OpenMusicKontrollers/chimaera_sensor_unit/(commit log)

2013-07-18 new revisions for the Chimaera and Sycamore boards, directory tree rewamp ongoing
    [Chimaera_SU-16_Unit.kicad_pcb, Chimaera_SU-16_Unit.sch]
2013-08-14 DSP-F3 rev3 (+1 analog input) and SU-16 rev7 (reverse current diode), Hershey fonts for case side
    [Chimaera_SU-16_Unit.kicad_pcb, Chimaera_SU-16_Unit.sch]
2013-08-16 last changes for Alpha Batch PCBs
    [Chimaera_SU-16_Unit.kicad_pcb, Chimaera_SU-16_Unit.sch]
2013-08-27 added README.md
    [Chimaera_SU-16_Unit.kicad_pcb]
2013-08-28 outsourced common parts to library
    [Chimaera_SU-16_Unit.kicad_pcb]
2013-10-24 0.9mm (elliptical) pad holes, 0.8x0.2mm text size
    [Chimaera_SU-16_Unit.kicad_pcb, Chimaera_SU-16_Unit.sch]
2014-01-02 EDA: add missing Digi-Key part numbers
    [Chimaera_SU-16_Unit.sch]
2014-03-02 solder paste clearence for 125um mylar stencils
    [Chimaera_SU-16_Unit.kicad_pcb]
2014-03-02 path fixes after repo split
    [chimaera_sensor_unit.kicad_pcb, chimaera_sensor_unit.sch]
2014-05-13 3v3 version of Rev7
    [chimaera_sensor_unit.kicad_pcb, chimaera_sensor_unit.sch]
2014-05-20 Revision 8 with single OpAmp, one trimpot less and a cap more for 3v3
    [chimaera_sensor_unit.kicad_pcb, chimaera_sensor_unit.sch]
2014-06-12 add missing Digi-Key part numbers
    [chimaera_sensor_unit.sch]
2014-11-16 update Digi-Key part number for A1304
    [chimaera_sensor_unit.sch]
2015-04-28 update from KiCAD oldstable to rolling-release.
    [chimaera_sensor_unit.kicad_pcb, chimaera_sensor_unit.sch]
