OpenMusicKontrollers/chimaera_sensor_unit/(notices)

Notices in the files:
chimaera_sensor_unit.kicad_pcb:
Copyright (c) 2015 Hanspeter Portner (dev@open-music-kontrollers.ch)
(c) 2014 Hanspeter Portner
Chimaera_SU-16_Unit.sch:
Copyright (c) 2013 Hanspeter Portner (dev@open-music-kontrollers.ch)
